FPGAwars/icezum/src-kicad/arduino-sockets.sch

## KiCad design src-kicad/arduino-sockets.sch (2017-11-30)

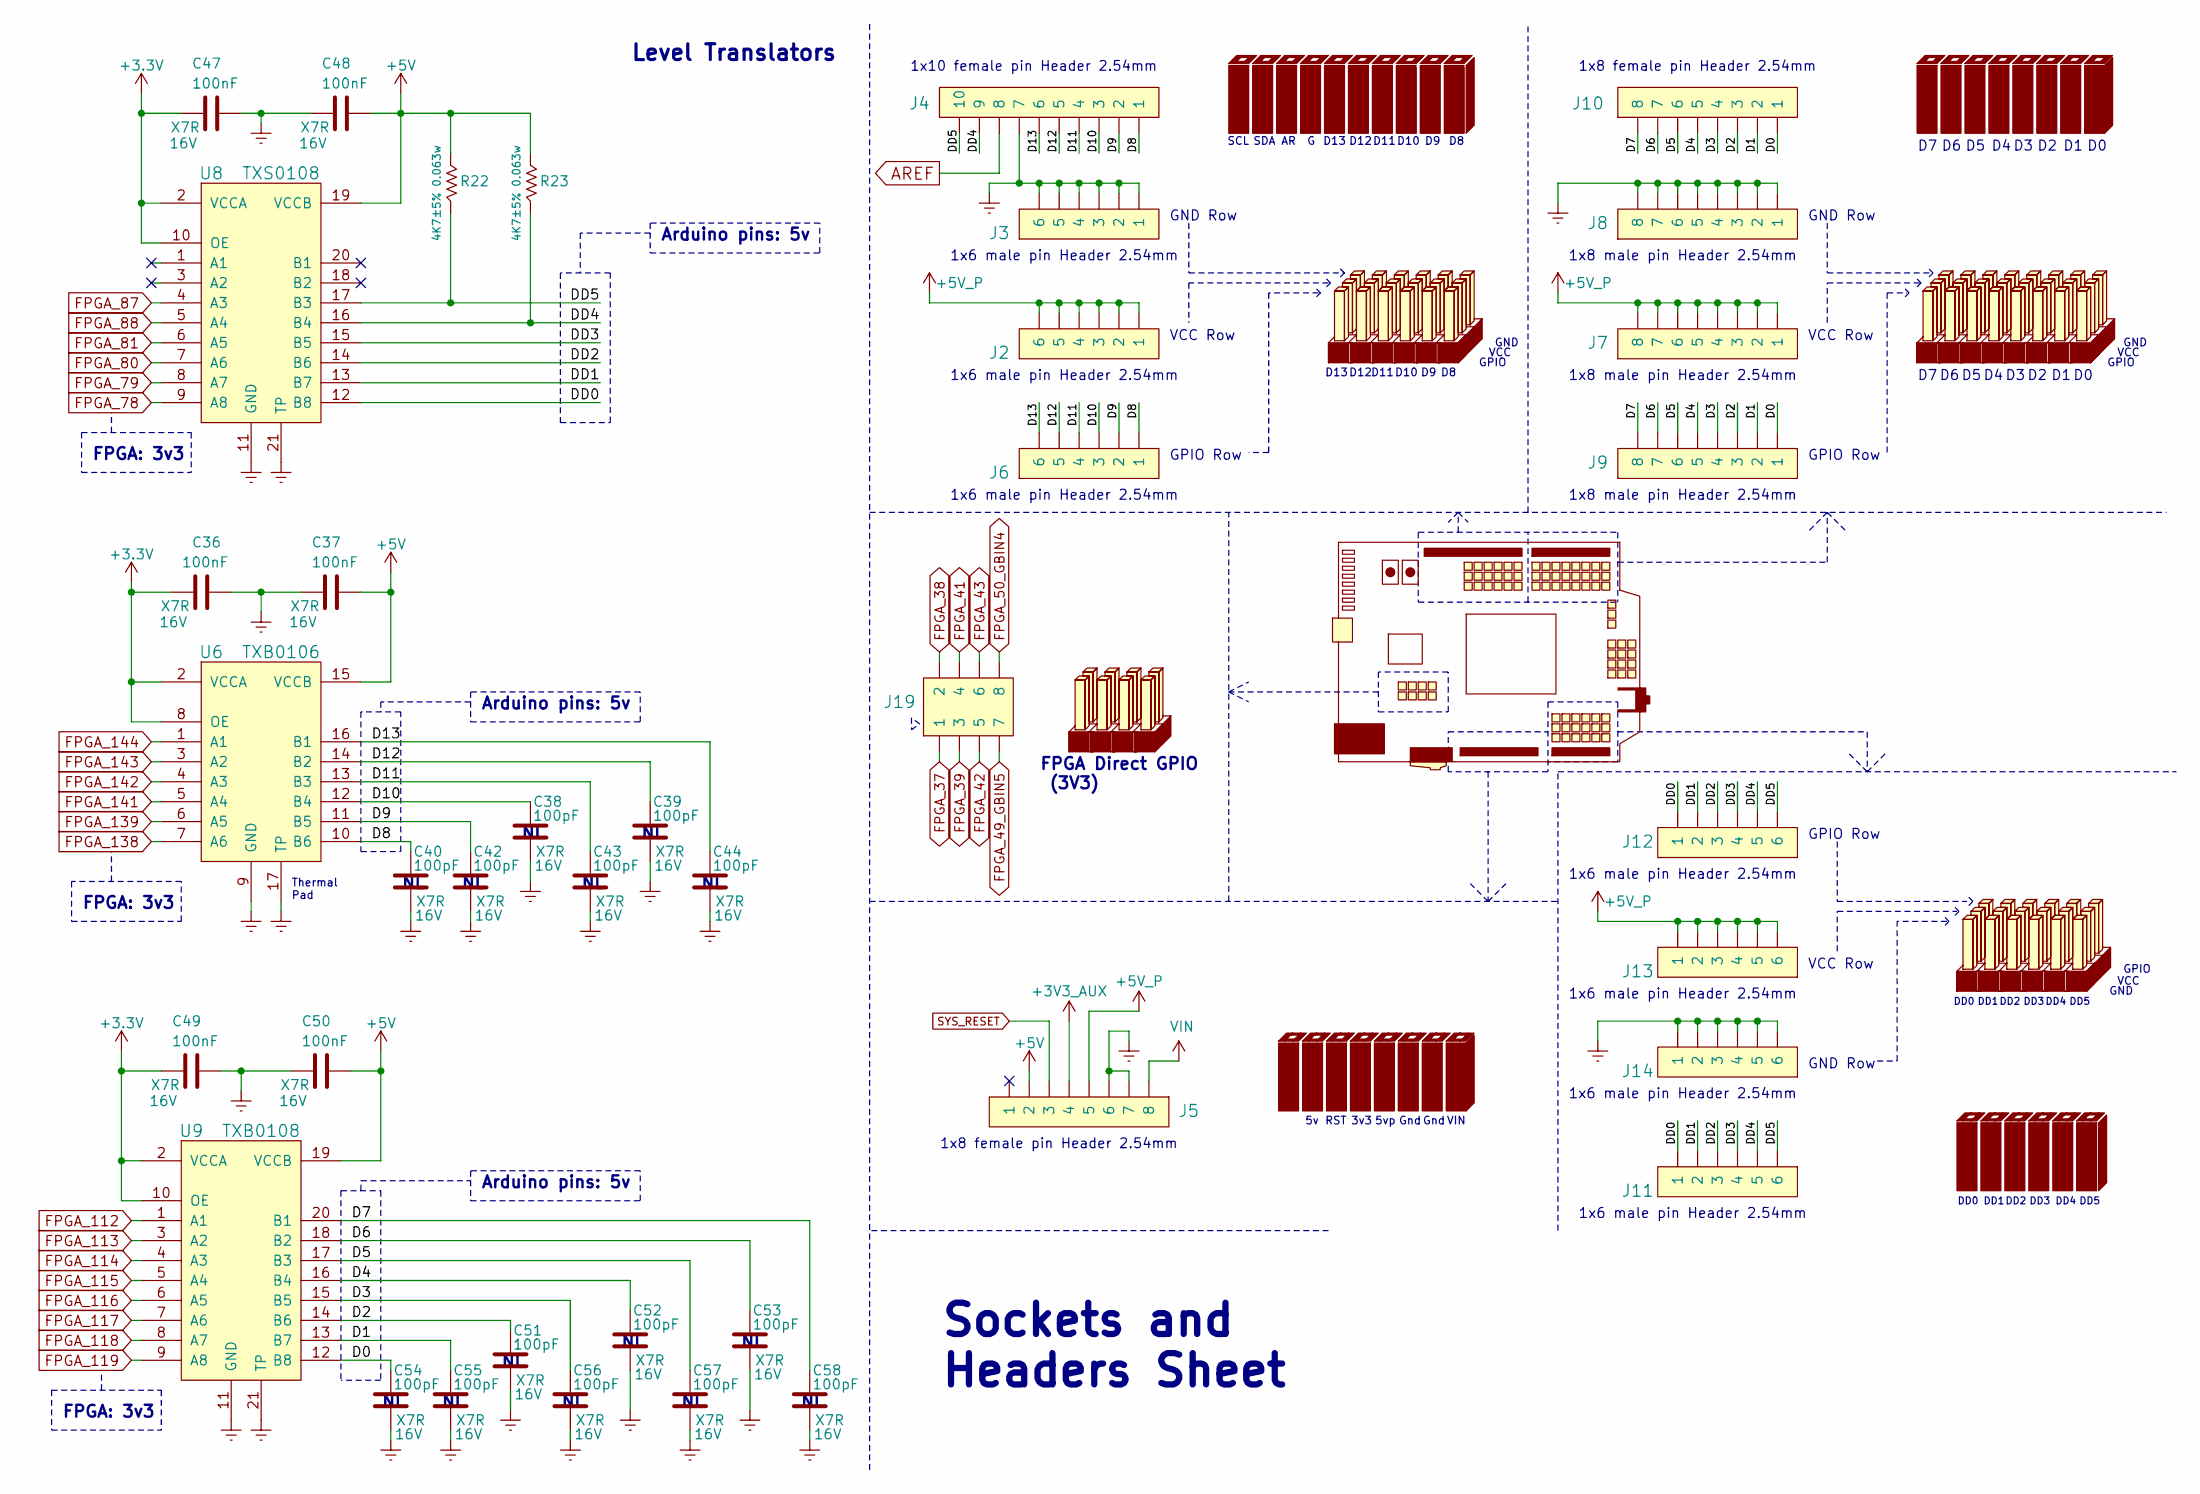
[picture p2: schematic arduino-sockets.sch]

Parts:
C36, C37, C47, C48, C49, C50: 100nF; C_0402; Voltage 16V
C38, C39, C40, C42, C43, C44, C51, C52, C53, C54, C55, C56, C57, C58: 100pF; C_0402; Voltage 16V
DOC1: icezum-headers-doc; None
J2, J3, J6, J12, J13, J14: 1x6_male_pin_Header_2.54mm; 1x6-pin-header-2.54mm
J4: 1x10_female_pin_Header_2.54mm; 1x10_socket-header-2.54mm
J5, J10: 1x8_female_pin_Header_2.54mm; 1x8_Socket_header_2.54mm
J7, J8, J9: 1x8_male_pin_Header_2.54mm; 1x8_pin_header_2.54mm
J11: 1x6_female_pin_Header_2.54mm; 1x6-Socket-header-2.54mm
J19: 2x4_male_pin_Header_2.54mm; 2x04-pin-header-2.54mm
R22, R23: 4K7±5% 0.063w; R_0402
U6: TXB0106; VQFN16_VIATP
U8: TXS0108; VQFN20_VIATP
U9: TXB0108; VQFN20_VIATP
doc1, doc6: 1x8_pin_female_header_DOC; None
doc2: 3x8_pin_male_header_DOC; None
doc3: 1x10_pin_female_header_DOC; None
doc4, doc7: 3x6_pin_male_header_DOC; None
doc5: 2x4_pin_male_header_DOC; None
doc8: 1x6_pin_female_header_DOC; None

Connections:
+3.3V: C36.2, C47.2, C49.2, U6.2 (VCCA), U6.8 (OE), U8.2 (VCCA), U8.10 (OE), U9.2 (VCCA), U9.10 (OE)
+3V3_AUX: J5.4
+5V: C37.1, C48.1, C50.1, J5.2, R22.2, R23.2, U6.15 (VCCB), U8.19 (VCCB), U9.19 (VCCB)
+5V_P: J2.1, J2.2, J2.3, J2.4, J2.5, J2.6, J5.5, J7.1, J7.2, J7.3, J7.4, J7.5, J7.6, J7.7, J7.8, J13.1, J13.2, J13.3, J13.4, J13.5, J13.6
AREF: J4.8
D0: C54.1, J9.1, J10.1, U9.12 (B8)
D1: C55.1, J9.2, J10.2, U9.13 (B7)
D2: C51.1, J9.3, J10.3, U9.14 (B6)
D3: C56.1, J9.4, J10.4, U9.15 (B5)
D4: C52.1, J9.5, J10.5, U9.16 (B4)
D5: C57.1, J9.6, J10.6, U9.17 (B3)
D6: C53.1, J9.7, J10.7, U9.18 (B2)
D7: C58.1, J9.8, J10.8, U9.20 (B1)
D8: C40.1, J4.1, J6.1, U6.10 (B6)
D9: C42.1, J4.2, J6.2, U6.11 (B5)
D10: C38.1, J4.3, J6.3, U6.12 (B4)
D11: C43.1, J4.4, J6.4, U6.13 (B3)
D12: C39.1, J4.5, J6.5, U6.14 (B2)
D13: C44.1, J4.6, J6.6, U6.16 (B1)
DD0: J11.1, J12.1, U8.12 (B8)
DD1: J11.2, J12.2, U8.13 (B7)
DD2: J11.3, J12.3, U8.14 (B6)
DD3: J11.4, J12.4, U8.15 (B5)
DD4: J4.9, J11.5, J12.5, R23.1, U8.16 (B4)
DD5: J4.10, J11.6, J12.6, R22.1, U8.17 (B3)
FPGA_37: J19.1
FPGA_38: J19.2
FPGA_39: J19.3
FPGA_41: J19.4
FPGA_42: J19.5
FPGA_43: J19.6
FPGA_49_GBIN5: J19.7
FPGA_50_GBIN4: J19.8
FPGA_78: U8.9 (A8)
FPGA_79: U8.8 (A7)
FPGA_80: U8.7 (A6)
FPGA_81: U8.6 (A5)
FPGA_87: U8.4 (A3)
FPGA_88: U8.5 (A4)
FPGA_112: U9.1 (A1)
FPGA_113: U9.3 (A2)
FPGA_114: U9.4 (A3)
FPGA_115: U9.5 (A4)
FPGA_116: U9.6 (A5)
FPGA_117: U9.7 (A6)
FPGA_118: U9.8 (A7)
FPGA_119: U9.9 (A8)
FPGA_138: U6.7 (A6)
FPGA_139: U6.6 (A5)
FPGA_141: U6.5 (A4)
FPGA_142: U6.4 (A3)
FPGA_143: U6.3 (A2)
FPGA_144: U6.1 (A1)
GNDREF: C36.1, C37.2, C38.2, C39.2, C40.2, C42.2, C43.2, C44.2, C47.1, C48.2, C49.1, C50.2, C51.2, C52.2, C53.2, C54.2, C55.2, C56.2, C57.2, C58.2, J3.1, J3.2, J3.3, J3.4, J3.5, J3.6, J4.7, J5.6, J5.7, J8.1, J8.2, J8.3, J8.4, J8.5, J8.6, J8.7, J8.8, J14.1, J14.2, J14.3, J14.4, J14.5, J14.6, U6.9 (GND), U6.17 (TP), U8.11 (GND), U8.21 (TP), U9.11 (GND), U9.21 (TP)
SYS_RESET: J5.3
VIN: J5.8

Notes on the sheet:
Level Translators
FPGA: 3v3
Arduino pins: 5v
1x8 female pin Header 2.54mm
1x8 male pin Header 2.54mm
GND Row
VCC Row
GPIO Row
GND
VCC
GPIO
D10
D11
D12
D13
SDA
SCL
1x10 female pin Header 2.54mm
1x6 male pin Header 2.54mm
DD5
DD4
DD3
DD2
DD1
DD0
Gnd
RST
VIN
3v3
5vp
FPGA Direct GPIO (3V3)
Sockets and Headers Sheet
Thermal Pad
