FPGAwars/icezum/src-kicad/fpga.sch

## KiCad design src-kicad/fpga.sch (2017-11-30)

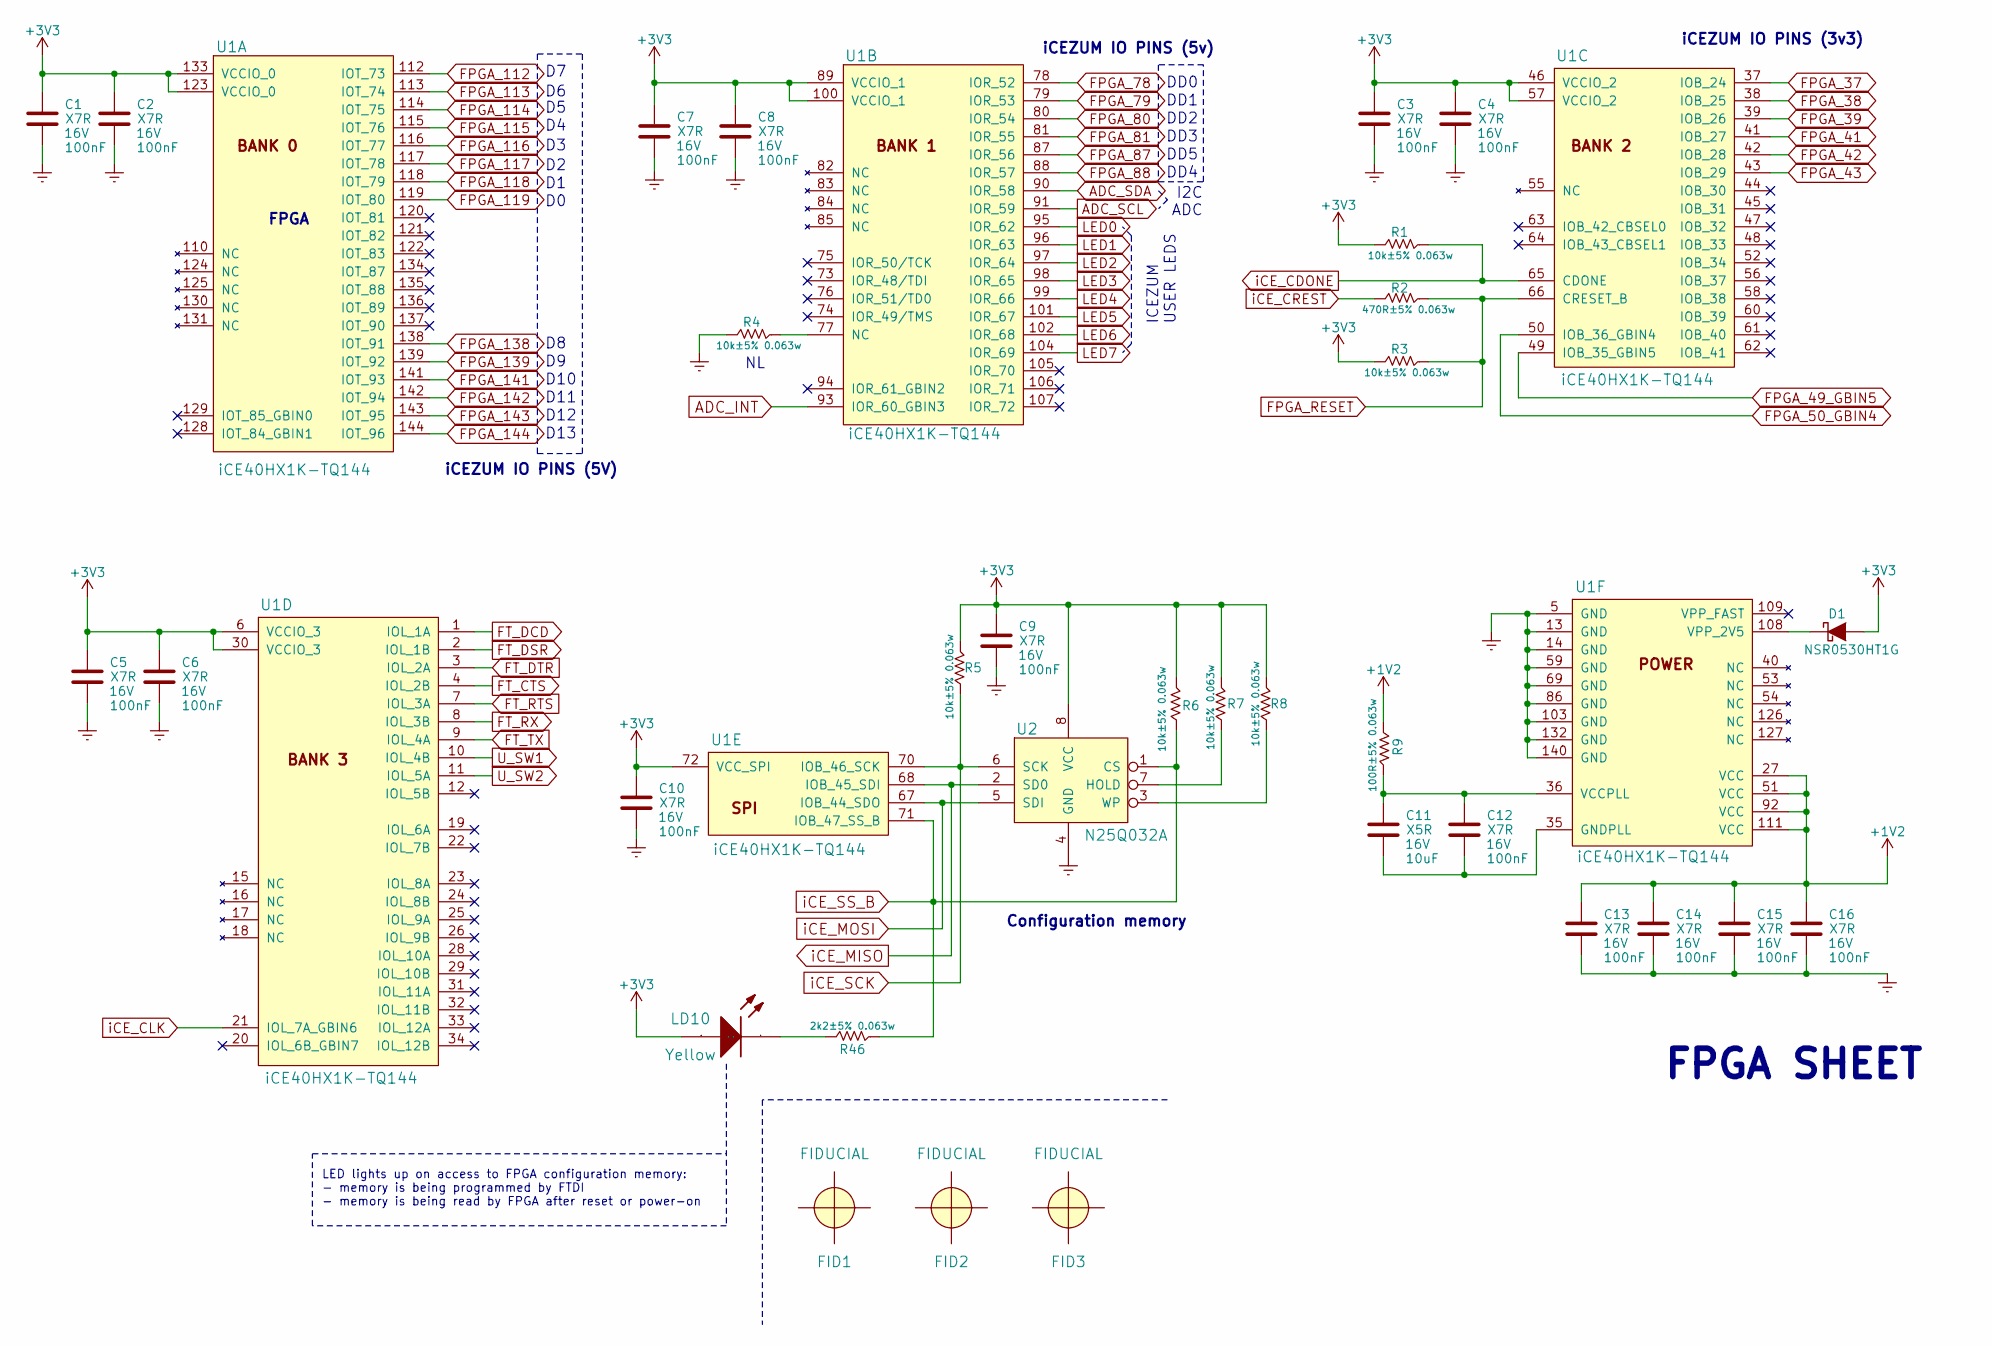
[picture p3: schematic fpga.sch]

Parts:
C1, C2, C3, C4, C5, C6, C7, C8, C9, C10, C12, C13, C14, C15, C16: 100nF; C_0402; Voltage 16V
C11: 10uF; C_0603; Voltage 16V
D1: NSR0530HT1G; SOD-323
FID1, FID2, FID3: FIDUCIAL; Fiducial
LD10: Yellow; LED_0603
R1, R3, R4, R5, R6, R7, R8: 10k±5% 0.063w; R_0402
R2: 470R±5% 0.063w; R_0402
R9: 100R±5% 0.063w; R_0402
R46: 2k2±5% 0.063w; R_0402
U1: iCE40HX1K-TQ144; TQFP-144_IPC-MD
U2: N25Q032A; DFN-8-6x5mm

Connections:
+1V2: C13.1, C14.1, C15.1, C16.1, R9.2, U1.27 (VCC), U1.51 (VCC), U1.92 (VCC), U1.111 (VCC)
+3V3: C1.1, C2.1, C3.1, C4.1, C5.1, C6.1, C7.1, C8.1, C9.1, C10.1, D1.2 (A), LD10.A, R1.2, R3.2, R5.1, R6.1, R7.1, R8.1, U1.6 (VCCIO_3), U1.30 (VCCIO_3), U1.46 (VCCIO_2), U1.57 (VCCIO_2), U1.72 (VCC_SPI), U1.89 (VCCIO_1), U1.100 (VCCIO_1), U1.123 (VCCIO_0), U1.133 (VCCIO_0), U2.8 (VCC)
ADC_INT: U1.93 (IOR_60_GBIN3)
ADC_SCL: U1.91 (IOR_59)
ADC_SDA: U1.90 (IOR_58)
FPGA_37: U1.37 (IOB_24)
FPGA_38: U1.38 (IOB_25)
FPGA_39: U1.39 (IOB_26)
FPGA_41: U1.41 (IOB_27)
FPGA_42: U1.42 (IOB_28)
FPGA_43: U1.43 (IOB_29)
FPGA_49_GBIN5: U1.49 (IOB_35_GBIN5)
FPGA_50_GBIN4: U1.50 (IOB_36_GBIN4)
FPGA_78: U1.78 (IOR_52)
FPGA_79: U1.79 (IOR_53)
FPGA_80: U1.80 (IOR_54)
FPGA_81: U1.81 (IOR_55)
FPGA_87: U1.87 (IOR_56)
FPGA_88: U1.88 (IOR_57)
FPGA_112: U1.112 (IOT_73)
FPGA_113: U1.113 (IOT_74)
FPGA_114: U1.114 (IOT_75)
FPGA_115: U1.115 (IOT_76)
FPGA_116: U1.116 (IOT_77)
FPGA_117: U1.117 (IOT_78)
FPGA_118: U1.118 (IOT_79)
FPGA_119: U1.119 (IOT_80)
FPGA_138: U1.138 (IOT_91)
FPGA_139: U1.139 (IOT_92)
FPGA_141: U1.141 (IOT_93)
FPGA_142: U1.142 (IOT_94)
FPGA_143: U1.143 (IOT_95)
FPGA_144: U1.144 (IOT_96)
FPGA_RESET: R2.1, R3.1, U1.66 (CRESET_B)
FT_CTS: U1.4 (IOL_2B)
FT_DCD: U1.1 (IOL_1A)
FT_DSR: U1.2 (IOL_1B)
FT_DTR: U1.3 (IOL_2A)
FT_RTS: U1.7 (IOL_3A)
FT_RX: U1.8 (IOL_3B)
FT_TX: U1.9 (IOL_4A)
GNDREF: C1.2, C2.2, C3.2, C4.2, C5.2, C6.2, C7.2, C8.2, C9.2, C10.2, C13.2, C14.2, C15.2, C16.2, R4.2, U1.5 (GND), U1.13 (GND), U1.14 (GND), U1.59 (GND), U1.69 (GND), U1.86 (GND), U1.103 (GND), U1.132 (GND), U1.140 (GND), U2.4 (GND)
LED0: U1.95 (IOR_62)
LED1: U1.96 (IOR_63)
LED2: U1.97 (IOR_64)
LED3: U1.98 (IOR_65)
LED4: U1.99 (IOR_66)
LED5: U1.101 (IOR_67)
LED6: U1.102 (IOR_68)
LED7: U1.104 (IOR_69)
unnamed: C11.1, C12.1, R9.1, U1.36 (VCCPLL)
unnamed: C11.2, C12.2, U1.35 (GNDPLL)
unnamed: D1.1 (K), U1.108 (VPP_2V5)
unnamed: LD10.K, R46.2
unnamed: R4.1, U1.77 (NC)
unnamed: R7.2, U2.7 (HOLD)
unnamed: R8.2, U2.3 (WP)
U_SW1: U1.10 (IOL_4B)
U_SW2: U1.11 (IOL_5A)
iCE_CDONE: R1.1, U1.65 (CDONE)
iCE_CLK: U1.21 (IOL_7A_GBIN6)
iCE_CREST: R2.2
iCE_MISO: U1.68 (IOB_45_SDI), U2.2 (SD0)
iCE_MOSI: U1.67 (IOB_44_SDO), U2.5 (SDI)
iCE_SCK: R5.2, U1.70 (IOB_46_SCK), U2.6 (SCK)
iCE_SS_B: R6.2, R46.1, U1.71 (IOB_47_SS_B), U2.1 (CS)

Notes on the sheet:
D13
D12
D11
D10
FPGA
iCEZUM IO PINS (5V)
DD0
DD1
DD2
DD3
DD4
DD5
iCEZUM IO PINS (5v)
ICEZUM USER LEDS
I2C ADC
iCEZUM IO PINS (3v3)
Configuration memory
FPGA SHEET
LED lights up on access to FPGA configuration memory: - memory is being programmed by FTDI - memory is being read by FPGA after reset or power-on
