FPGAwars/icezum/(notices)

Notices in the files:
src-kicad/peripherals.sch:
License: Creative commons Attribution ShareAlike
